msx-hws/1MB4MSX-public/3d-enclosure/1MB4MSX_Cartridge_preview.png

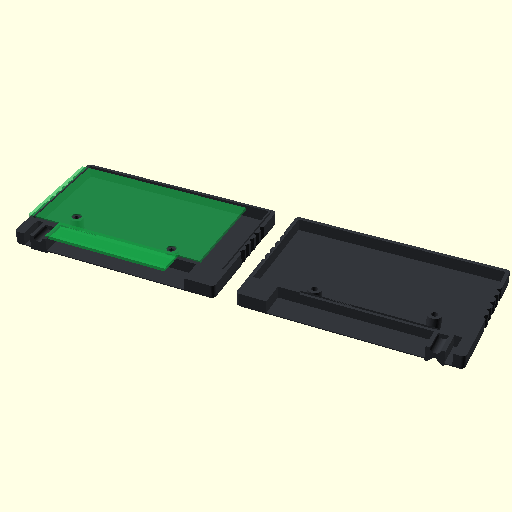
3d-enclosure/1MB4MSX_Cartridge_preview.png
