msx-hws/1MB4MSX-public/images/case_blue_front.jpg

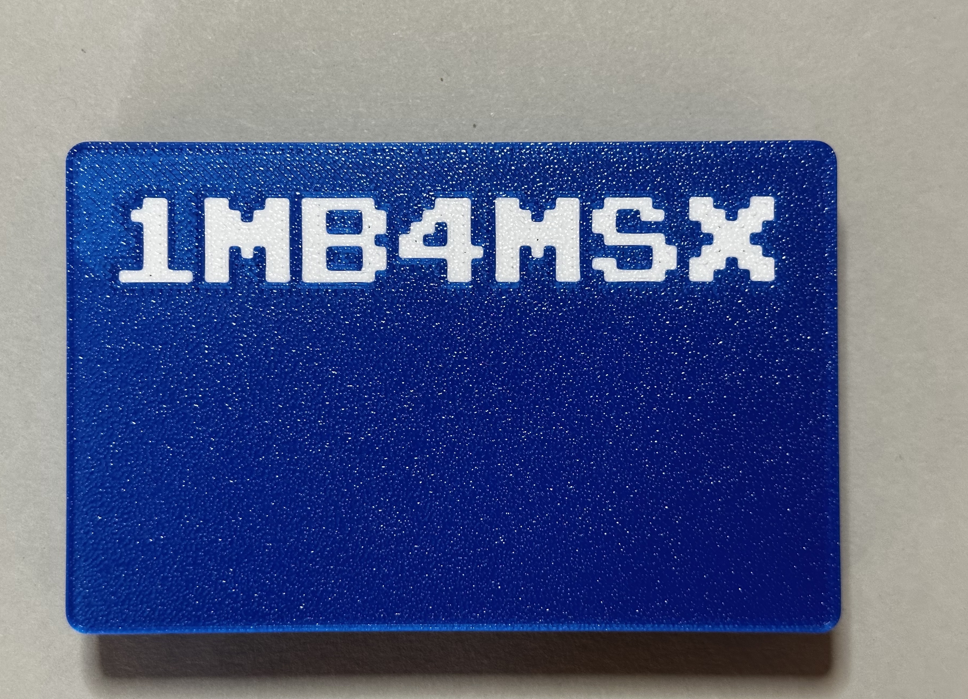
images/case_blue_front.jpg
