msx-hws/1MB4MSX-public/images/pcb_back.jpeg

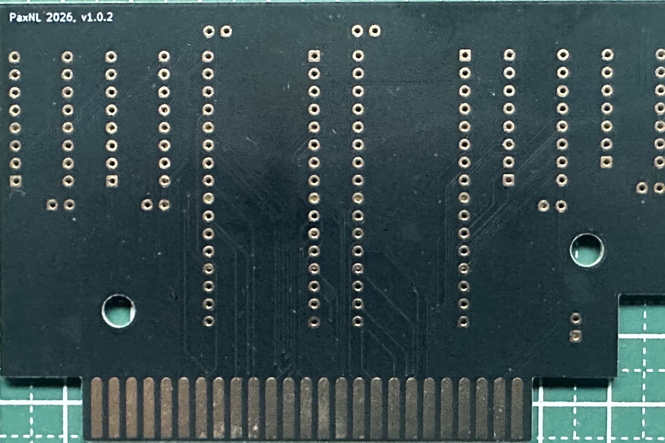
images/pcb_back.jpeg
