msx-hws/1MB4MSX-public/images/pcb_front.jpeg

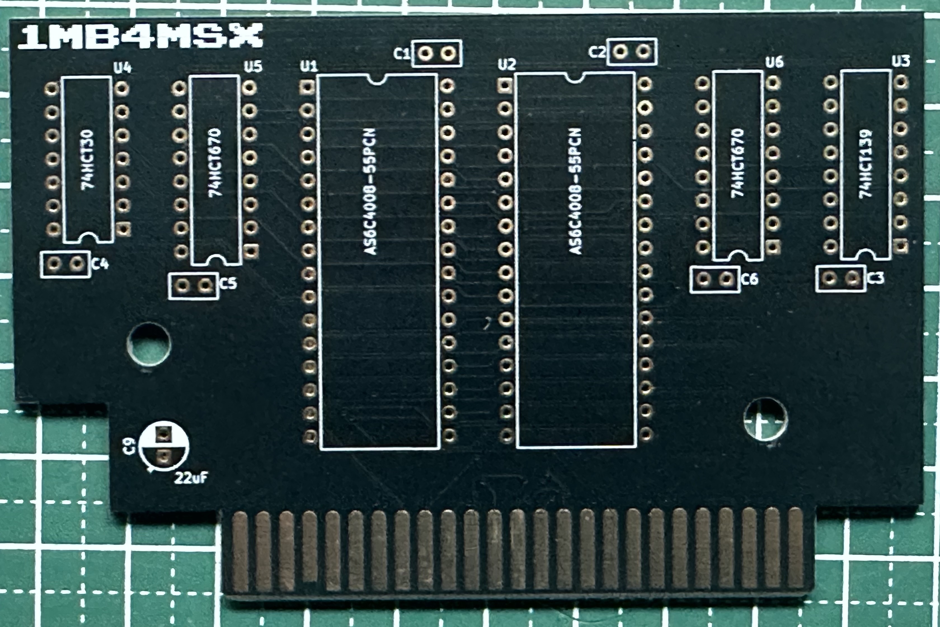
images/pcb_front.jpeg
