msx-hws/1MB4MSX-public/bom/1MB4MSX-bom.csv

Refs | Value | Footprint | Qty | DNP
C1 | 100nF | Capacitor_THT:C_Disc_D5.0mm_W2.5mm_P2.50mm | 1
C2 | 100nF | Capacitor_THT:C_Disc_D5.0mm_W2.5mm_P2.50mm | 1
C3 | 100nF | Capacitor_THT:C_Disc_D5.0mm_W2.5mm_P2.50mm | 1
C4 | 100nF | Capacitor_THT:C_Disc_D5.0mm_W2.5mm_P2.50mm | 1
C5 | 100nF | Capacitor_THT:C_Disc_D5.0mm_W2.5mm_P2.50mm | 1
C6 | 100nF | Capacitor_THT:C_Disc_D5.0mm_W2.5mm_P2.50mm | 1
C7 | 22uF | Capacitor_THT:CP_Radial_D5.0mm_P2.50mm | 1
J1 | MSX-Cartridge | PaxNL:MSX Cartridge | 1
U1 | 74HCT670 | Package_DIP:DIP-16_W7.62mm | 1
U2 | 74HCT670 | Package_DIP:DIP-16_W7.62mm | 1
U3 | 74LS139 | Package_DIP:DIP-16_W7.62mm | 1
U4 | 74HCT30 | Package_DIP:DIP-14_W7.62mm | 1
U5 | AS6C4008-55PCN | Package_DIP:DIP-32_W15.24mm | 1
U6 | AS6C4008-55PCN | Package_DIP:DIP-32_W15.24mm | 1
