msx-hws/1MB4MSX-public/3d-enclosure/1MB4MSX-bottom.3mf

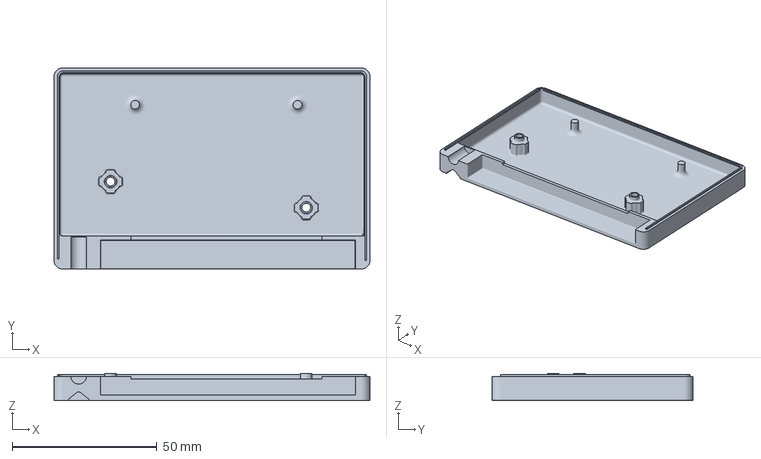
[picture p11: CAD file, 2026-10-10]
3d-enclosure/1MB4MSX-bottom.3mf
109.0 x 69.4 x 9.40 mm
