msx-hws/1MB4MSX-public/3d-enclosure/1MB4MSX-case.3mf

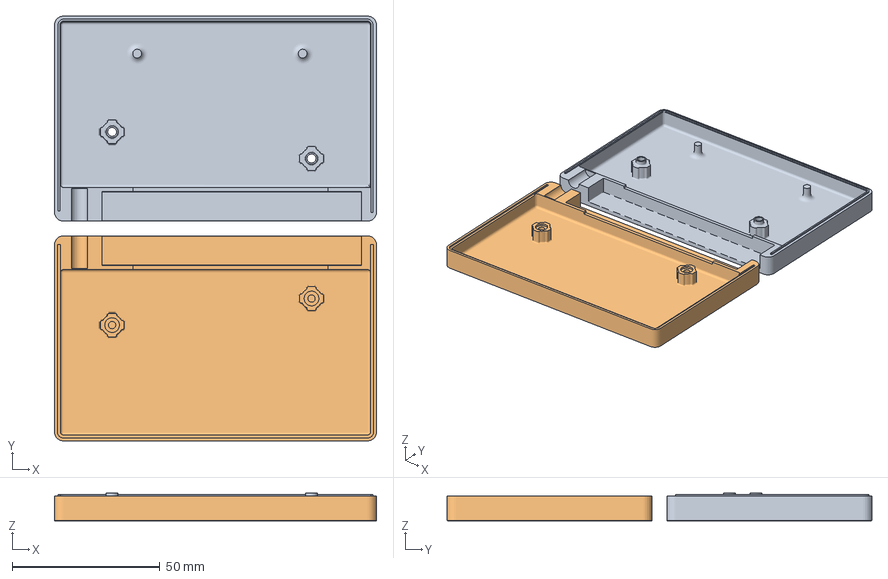
[picture p12: CAD file, 2026-10-10]
3d-enclosure/1MB4MSX-case.3mf
109.0 x 143.8 x 9.40 mm
bottom
top
