msx-hws/1MB4MSX-public/3d-enclosure/1MB4MSX-front.3mf

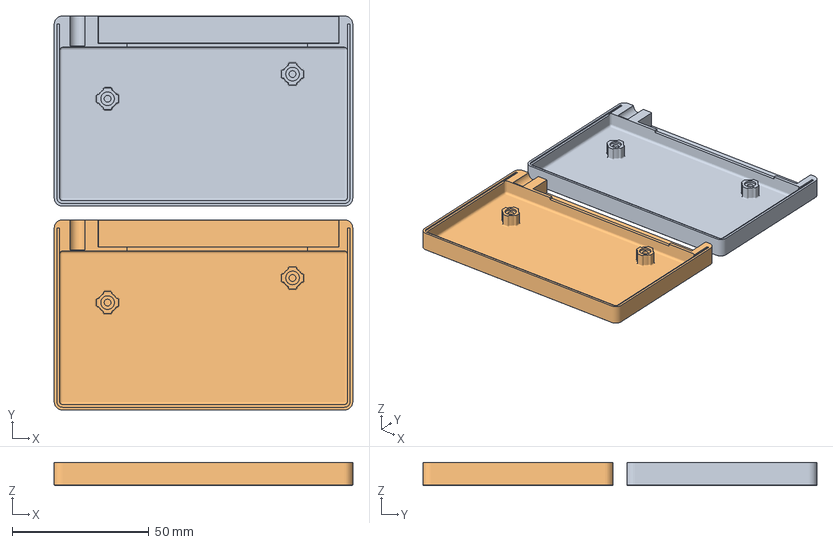
[picture p13: CAD file, 2026-10-10]
3d-enclosure/1MB4MSX-front.3mf
109.0 x 143.8 x 8.40 mm
top x 2
