msx-hws/1MB4MSX-public/docs/1MB4MSX-Schematic.pdf

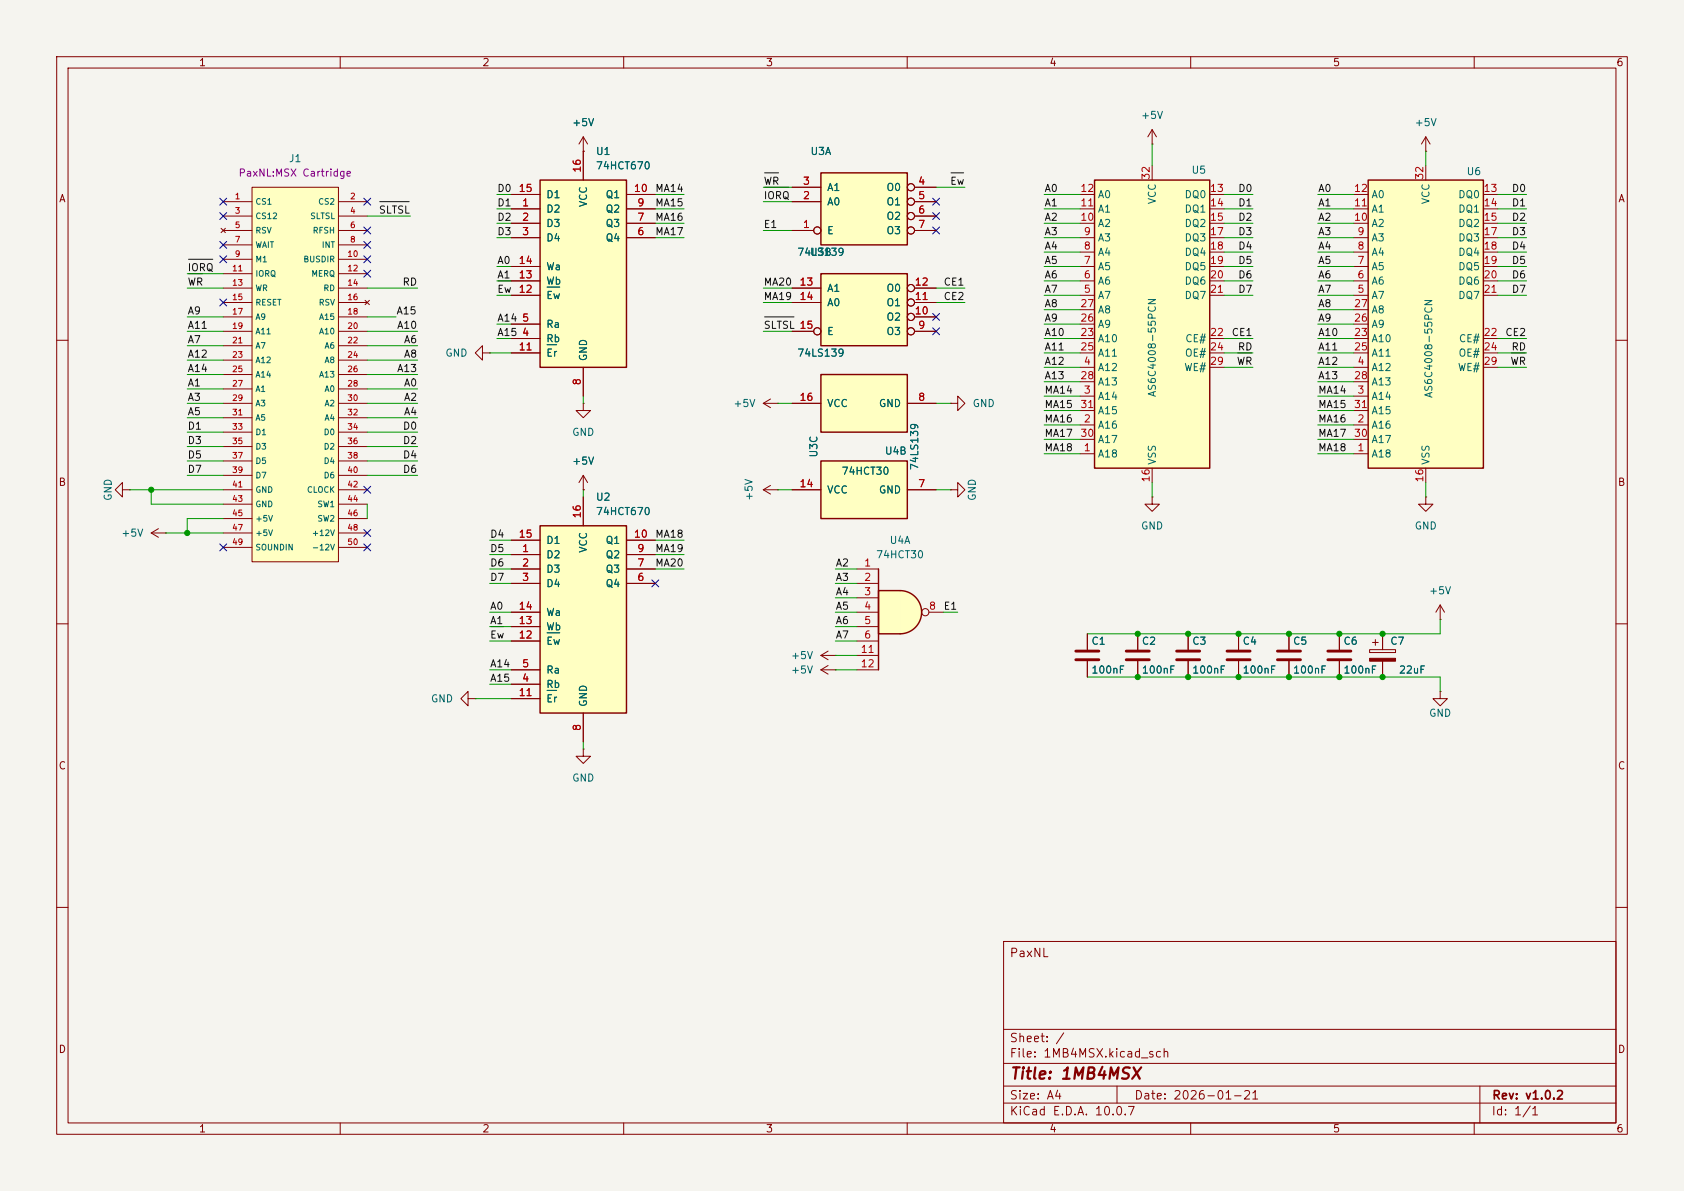
[picture p14: page 1]

Size: A4 | Rev: v1.0.2
KiCad E.D.A. 10.0.7 | Id: 1/1
