msx-hws/1MB4MSX-public/(commit log)

2026-10-10 initial commit: 1MB4MSX memory mapper cartridge repository setup
    [1MB4MSX-B_Courtyard.gbr, 1MB4MSX-B_Cu.gbl, 1MB4MSX-B_Fab.gbr, 1MB4MSX-B_Mask.gbs, 1MB4MSX-B_Paste.gbp, 1MB4MSX-B_Silkscreen.gbo, 1MB4MSX-Edge_Cuts.gm1, 1MB4MSX-F_Courtyard.gbr]
2026-10-10 add live interactive BOM GitHub Pages link and set linguist documentation on HTML
2026-10-11 enable dark mode by default in ibom.html and add quantity count to BOM table in README
2026-10-19 chore: sync latest 1MB4MSX gerbers, renders, and 3d enclosure
    [1MB4MSX-B_Cu.gbl, 1MB4MSX-B_Mask.gbs, 1MB4MSX-B_Paste.gbp, 1MB4MSX-B_Silkscreen.gbo, 1MB4MSX-Edge_Cuts.gm1, 1MB4MSX-F_Cu.gtl, 1MB4MSX-F_Mask.gts, 1MB4MSX-F_Paste.gtp]
2026-10-19 chore: sync gerbers, 3d renders, and BOM from 1MB4MSX
    [1MB4MSX-B_Cu.gbl, 1MB4MSX-B_Mask.gbs, 1MB4MSX-B_Paste.gbp, 1MB4MSX-B_Silkscreen.gbo, 1MB4MSX-Edge_Cuts.gm1, 1MB4MSX-F_Cu.gtl, 1MB4MSX-F_Mask.gts, 1MB4MSX-F_Paste.gtp]
